fengjh97/robotiq-2f140-td005g-jaw/v7_PLA_only/README.md

# v7：纯 PLA 版（不用 TPU）

> **拷 U 盘直接打 → 用 [`USB_gcode/`](USB_gcode) 里的 `.gcode.3mf`**（已经切好片；PLA 装在哪个喷头，就选文件名带 `_LEFT` 还是 `_RIGHT` 的）。这一层的 `.3mf` 是工程文件，要先在 Bambu Studio 里切片才能打。

**只有 PLA 时用这个文件夹**：只用左喷头，全程不换料。

## 文件
| 顺序 | 文件 | 内容 | 时间* | 用料 |
|---|---|---|---|---|
| ① 试作件 | `trial_v7_PLA_rings_SML.3mf` | 7 mm 厚的环切片，S/M/L 各 2 个（刻痕 1/2/3 道 = S/M/L），从左到右排列 | **约 1 小时 6 分** | 30 g |
| ② 正式件 | `final_v7_S_PLA_only_H2DPro.3mf` / `final_v7_M_…` / `final_v7_L_…` | 两个夹爪，根部 100% 填充修改器已设好 | **约 7 小时** | 约 245 g |

\*用 OrcaSlicer 2.4.2 和 Bambu H2D Pro 0.4 喷嘴官方配置实际切片得到。3MF 里还留着 TPU 这个耗材槽，但没有用到，可以不管。

## 怎么箍住（不靠软材料）
PLA 不适合做弹簧，长期受力会蠕变、慢慢松掉，所以这一版完全靠几何结构：
1. **贴合的硬环**：环腔只比握把大 **0.3 mm**。用 S/M/L 试作件挑出最贴合的尺寸，S/M/L 之间半径差 0.6 mm。
2. **横向细齿 + 锥度楔紧**：环内侧有一圈圈 0.5 mm 高的横向细齿，咬住握把表面的橡胶。握把上粗下细，起子一往下滑就会楔紧在环里。
3. **机头托底**：万一起子往下滑，最多滑几毫米，机头就会落到夹爪的“肩膀”上，掉不下去。
4. **自锁**：2F-140 是自锁的，起子往外撑也推不开手指。

## 选尺寸标准（在扳机下方、离机头底面约 4–5 cm 的地方试）
| 手感 | 判断 |
|---|---|
| ✅ 两个半环用手轻轻一压就完全合上，榫头能插进去；合上后起子基本不晃，往下拉时能感觉到细齿咬住 | **就是这个尺寸** |
| 合不上，还留着缝 | 太紧，换小一号 |
| 合上以后起子明显能晃、能转 | 太松，换大一号 |

挑出来以后，直接打同字母的 `final_v7_*`。

## 跟 v6（PLA + TPU）比
- **少了 TPU 内衬**：容错从约 ±0.8 mm 降到约 ±0.3 mm，所以**一定要先打试作件选尺寸**。
- **不变的部分**：本体结构、M5×16 螺丝加外径 12 mm 垫圈、拧紧力矩 0.8 N·m、夹持力 25–35 N、强度分析结论，都跟 v6 一样。
- **对位精度**：环跟握把只差 0.3 mm，机器人前后方向尽量对准在 ±2 mm 以内。偏了的话，环的弧面会把起子推正，起子是立在桌上的，推得动。
- **碰撞检查**（模型）：
  - 抓住时两个夹爪离握把都是 0.29 mm
  - 合拢全过程，在高度误差 ±3 mm 范围内都不碰，最小间隙 0.17 mm
  - 全开往下伸经过机头时，间隙 2.66 mm

## 打印设置（3MF 里已经设好，在 Bambu Studio 里打开就行）
| 项目 | 设置 |
|---|---|
| 打印机 | Bambu Lab H2D Pro，0.4 喷嘴 |
| 基础工艺 | 0.20mm Standard @BBL H2DP（Bambu 官方预设） |
| 耗材 | Bambu PLA Basic，**左喷头**（文件里还有一个 TPU 槽位，没用到，不用管） |
| 热床板 | **纹理 PEI 板**，55 °C |
| 喷嘴温度 | 220 °C |
| 层高 | 0.2 mm（首层也是 0.2 mm） |
| 支撑 | 不加（背面朝下摆放，悬空部分都在 45° 以内） |
| 擦料塔 | 关 |
| 速度、风扇、边缘（brim） | 用官方默认值（外墙 200 / 内墙 300 / 填充 350 mm/s，风扇最大 80%，边缘自动） |

| | 试作件 `trial_v7` | 正式件 `final_v7_S/M/L` |
|---|---|---|
| 墙数 | 3 圈 | **5 圈** |
| 顶层 / 底层 | 各 4 层 | **各 6 层** |
| 填充 | 15% 螺旋体 | **20% 螺旋体** |
| 根部加强 | 没有 | 靠螺丝孔那一端 25 mm 用 **100% 填充**（透明修改器 `root_100pct`，本身不打印） |
| 时间 / 用料 | 约 1 小时 6 分 / 30 g | 约 7 小时 / 245 g |

墙数、顶底层和根部填充是按强度分析定的：应力集中在表面和根部，所以加墙、加根部填充比整体加填充更有效。
