fengjh97/robotiq-2f140-td005g-jaw/v7_PLA_only/USB_gcode/README.md

# 拷 U 盘直接打印的切片文件（.gcode.3mf）

这些文件**已经切好片**，拷到 U 盘、插到 H2D Pro 上，在屏幕里选中就能打印。

## 先确认 PLA 装在哪个喷头上
打印机屏幕 → **耗材**：看 PLA 是挂在左喷头还是右喷头（AMS 接在哪一边，或者用的哪边外挂料架）。

| PLA 装在 | 用文件名带这个后缀的 |
|---|---|
| **左**喷头 | `…_LEFT.gcode.3mf` |
| **右**喷头 | `…_RIGHT.gcode.3mf` |

## 打哪个
| 顺序 | 文件 | 时间 | 用料 |
|---|---|---|---|
| ① 试作件 | `trial_v7_PLA_rings_SML_LEFT/RIGHT` | 约 1 小时 6 分 | 30 g |
| ② 正式件（选试作件里合适的尺寸） | `final_v7_S_…` / `final_v7_M_…` / `final_v7_L_…` | 约 7 小时 | 约 245 g |
| ②' **XXL 正式件**（L 也紧的话打这个） | `final_v7_XXL_PLA_only_H2DPro_LEFT/RIGHT` | 约 6 小时 53 分 | 约 242 g |

## U 盘打印步骤
1. U 盘格式要是 FAT32 或 exFAT，把 `.gcode.3mf` 文件拷进去（放在根目录最好找）。
2. U 盘插到打印机的 USB 口上 → 屏幕上进**文件**（存储）→ 选 U 盘 → 选文件。
3. 开始前确认：耗材 1（PLA）对应到实际装 PLA 的那个槽或料架；热床板放的是**纹理 PEI 板**。然后开始打印。

## 说明
- 用 **OrcaSlicer 2.4.2** 加 **Bambu Lab H2D Pro 0.4 喷嘴官方配置**（工艺 0.20mm Standard、耗材 Bambu PLA Basic）切的；机型 ID 已经设成 H2D Pro（O1E），G-code 校验值没问题，带预览图。
- 如果打印机提示“文件不是用 Bambu Studio 生成的”之类的话，选继续就行。万一打印机拒绝打印，就在电脑上用 Bambu Studio 打开上一层文件夹里对应的 `.3mf`（不带 gcode 的那个）→ 切片 → “导出切片文件”，再拷到 U 盘。
- 设置：试作件 3 圈墙、15% 填充；正式件 5 圈墙、顶底各 6 层、20% 螺旋体填充，根部 25 mm 是 100% 填充；层高 0.2 mm，喷嘴 220 °C，热床 55 °C，不加支撑。

## XXL（2026-10-26 新增）
实际试装发现 L 还是有点紧，所以加了 XXL：环腔半径比 L 大 1.2 mm（比 M 大 1.8 mm），其他结构跟 S/M/L 完全一样。

## M+5mm（2026-10-26 新增）
环的**内径比 M 大 5 mm**（半径大 2.5 mm，比 XXL 还大 0.7 mm）。为了让环两端的壁保持够厚，夹爪宽度从 62 mm 加到 **68 mm**，其他结构不变。
文件：`final_v7_Mplus5mm_PLA_only_H2DPro_LEFT/RIGHT.gcode.3mf`，约 **7 小时 35 分**，PLA 约 263 g，一盘出两个夹爪。
