fengjh97/robotiq-2f140-td005g-jaw/docs/pla_design_notes_v5_zh.md

# v5 PLA 版：Robotiq 2F-140 × Makita TD005G 环抱式夹爪

抓取姿态跟 v4 一样：夹爪倾斜 9°，越过扳机，环抱在机头底面往下 33–64 mm 的握把上。这一版只针对 **PLA 的弱点**做了加强。

## PLA 的问题和对策
Bambu PLA Basic 官方数据：拉伸强度 39 MPa（沿层）/ 35 MPa（跨层），弯曲强度 76 / 68 MPa，热变形温度 54 °C。短期强度跟 PETG-CF 差不多，但有三个弱点。

| PLA 的弱点 | 会出什么问题 | v5 的对策 |
|---|---|---|
| **蠕变**（长期受力会慢慢变形） | 螺丝头下面的塑料被慢慢压扁，螺丝松动，指尖晃 | 螺丝换 **M5×16**，底板加厚到 **8 mm**（螺纹拧进夹爪的深度还是 8 mm，跟原厂一样）；螺丝头下加**外径 12 mm 的大垫圈**，承压面积是不加垫圈的 2.8 倍；夹持力降到 **25–35 N**，螺丝拉力降到原来的四分之一左右 |
| **脆**（受冲击容易裂） | 撞了容易断 | 应力水平压得很低；同时它也起到保险丝的作用，撞了是 PLA 指尖断，不是夹爪本体坏。**建议多打一对备用** |
| **怕热**（54 °C 开始软化） | 放在车里或者阳光下会变形 | 室内使用没问题；夏天别放在车里 |
| 没有 TPU 做内衬 | — | 环内侧贴 **2 mm 厚 EPDM 海绵胶带**（五金店的“隙間テープ”），或者 **1 mm 厚橡胶片**。两种都行，环腔已经按这两种厚度留好了 1.2 mm 的空间 |

## 有限元结果（PLA，E = 2.68 GPa）
P1 单元会低估约 20%，下表已经乘了 1.2 修正。“最大”是 99.9 分位值，括号里是局部峰值。

| 工况 | 最大 von Mises 应力 | 跨层拉应力 | 环处变形 |
|---|---|---|---|
| 夹持 30 N | 2.3（3.4）MPa | 1.8 MPa | 0.12 mm |
| 夹持 30 N + 起子悬挂按 3g 算 | 2.9（4.4）MPa | 2.2 MPa | 0.16 mm |
| 夹持 30 N + 侧向 30 N（最危险的工况） | 4.2（5.5）MPa | 2.6 MPa | 0.21 mm |
| 对比：开满力 125 N | 9.5（14）MPa | 7.3 MPa | 0.50 mm |

- **短期安全系数**：跨层 35 / 2.6 ≈ **13 倍**。
- **长期蠕变**：PLA 在室温下长期受力，大约强度的 20%（约 7 MPa）以内不会明显蠕变。30 N 各工况都在这个范围内，安全系数约 **2.5 倍**。
- 如果开满力 125 N，跨层应力会超过 7 MPa，PLA 会慢慢变形，**所以一定不要开满力**。

## 螺丝接口
螺丝拉力约等于夹持力 × 80 / 5.35。

| 夹持力 | 螺丝拉力 | 垫圈下承压（外径 12 mm 垫圈，承压面积 91 mm²） |
|---|---|---|
| 30 N | 450 N | 4.9 MPa ✓ |
| 50 N | 750 N | 8.2 MPa（开始有蠕变风险） |
| 125 N | 1870 N | 21 MPa ✗ |

- **拧紧力矩 0.8 N·m**，预紧力约 800 N，大于工作时的 450 N，接合面不会张开；垫圈下面约 9 MPa，PLA 能接受。
- 螺纹胶用**中强度**（蓝色）。因为预紧力比较小，要靠螺纹胶防松。
- 用 24 小时后复拧一次，以后每个月检查一下。

## 够不够抓得住（30 N）
- **环形封闭**：前后左右都关住了；椭圆截面在椭圆环里也转不动。
- **锥度楔紧**：握把上粗下细，起子往下滑会楔死在环里。往外撑的力由 2F-140 的自锁机构承受。
- **摩擦**：EPDM 和握把之间 μ 约 0.8，摩擦力 2 × 0.8 × 30 = 48 N，超过按 3g 算的设计载荷 44 N。
- **结论**：30 N 就够用。不要为了“更稳”去开大力，那只会让 PLA 蠕变。

## 打印参数（Bambu PLA Basic，H2D Pro）
- **摆放**：背面贴床（STL 已经摆好），不用支撑。这样根部弯曲的主应力走在层内。
- **层高**：0.2 mm。墙 **6 圈**，顶底各 **6 层**。
- **填充**：30% 螺旋体（gyroid）。加一个修改器，把**安装面往上 25 mm 的根部**填充改成 **100%**：打印方向上就是零件**靠近螺丝孔那一端、长约 25 mm 的一段**。
- **喷嘴温度**：220 °C（比默认高 5–10 °C，层间结合更好）。外墙速度放慢一点。
- **单件**约 140–160 g，2 件放一块板。
- **试装**：先打 `FITTEST_ring_v5_PLA_x2.stl` 两个（大约 1 小时），**贴好胶带**套到真起子上试，确认能合拢、不太紧也不晃。

## 需要准备的零件
- M5×16 内六角螺丝 2 颗（原厂的 M5×12 在这一版**太短**，不能用）
- M5 平垫圈，外径 12 mm（外径 10 mm 也能装，但承压面积会小一些）2 片
- 2 mm EPDM 海绵胶带，或者 1 mm 橡胶片（贴在环腔内侧，避开两半环的对接面）
- 能伸进去 110 mm 以上的 4 mm 内六角（长柄球头内六角，或者 4 mm 六角批头加加长杆）
- 中强度螺纹胶

## 装配
1. 环腔内侧贴胶带：只贴中间那一段（就是比上下稍微凹进去一点的区域），对接面和榫头上不要贴。
2. 拧下原厂指尖，**定位销留在夹爪上**。把 PLA 指尖对准定位销放上去。
3. 从指尖最下端的孔，依次把垫圈和 M5×16 螺丝放进去（可以用一点双面胶或磁铁把垫圈临时粘在螺丝头上）。用长内六角拧到 **0.8 N·m**。
4. 两个指尖是同一个零件，另一个转 180° 装在另一根手指上。
5. 夹持力设 **25–35 N**，先空夹确认两半环能合上，再去抓起子。
