fengjh97/robotiq-2f140-td005g-jaw/docs/v6_design_notes_zh.md

# v6：PLA 本体 + TPU 方向性软鳍内衬

抓取姿态跟 v4/v5 一样：夹爪倾斜 9°，越过扳机，环抱在机头底面往下 33–64 mm 的握把上。本体结构跟 v5 一样（M5×16 螺丝、8 mm 底板、外径 12 mm 大垫圈），区别在环内侧：**泡棉胶带换成了 TPU 软鳍内衬**。

## 为什么 PLA + TPU 更好
| 方案 | 两半环能不能合上（30 N 夹持力） | 握把尺寸误差容忍度 | 防止往下滑 |
|---|---|---|---|
| v4.1 实心 TPU 肋 | 合不上，95A 太硬压不动，会留约 0.6 mm 的缝 | 约 ±0.3 mm | 一般 |
| v5 泡棉胶带 | 基本能合上 | 约 ±0.5 mm | 一般，泡棉会老化 |
| **v6 TPU 软鳍** | **能完全合上**（鳍片完全压平只需约 16 N/侧） | **约 ±0.8 mm** | **方向性：往下滑的阻力远大于合拢时的阻力** |

**软鳍的原理**
- 鳍片厚 0.8 mm、长 3.5 mm，**斜 45° 朝向机头**，一共 7 圈，自由状态下鳍尖伸进握把 0.8 mm。
- 2F-140 合拢时指尖走圆弧，环会**顺着握把往下滑约 19 mm**。这个方向相当于顺着鳍片的倒向，鳍片被顺势压平，几乎不阻碍合拢。
- 起子要往下掉时方向相反，鳍尖被往下拖、立起来顶住，像倒刺一样**越拉越紧**。
- PLA 负责结构强度，TPU 负责贴合和抓握，各干各擅长的事。

## 强度（有限元，PLA，夹持力 30 N）
跟 v5 基本一样。最坏工况（夹持 30 N + 侧向 30 N）：
- von Mises 约 3.3 MPa（99.9 分位），局部峰值约 4.8 MPa
- 跨层拉应力 2.3 MPa
- 环处变形 0.17 mm

内衬凹槽加深对强度没有影响，因为应力都集中在根部，环那一段基本不受力。短期安全系数约 15 倍，长期蠕变约 3 倍。螺丝拉力 450 N，垫圈下承压 4.9 MPa。

## 碰撞检查（运动学模型）
| 项目 | 结果 |
|---|---|
| 全开下探过机头 | 最小间隙 2.7 mm |
| 合拢全过程（夹爪高度误差 ±3 mm） | 不碰起子，最小间隙 0.9 mm |
| 抓住时 PLA 硬壳到握把 | 1.2–1.4 mm（这里是软鳍的位置） |
| 指尖到夹爪自身连杆 | 最小 1.0 mm |

## 打印时间和用料（OrcaSlicer 2.4.2 实际切片，Bambu Lab H2D Pro 0.4 喷嘴官方配置）
| 任务 | 内容 | 设置 | 时间 | 用料 |
|---|---|---|---|---|
| ① 试装（推荐先打） | `FITTEST_ring_slice_v6_x2`：12 mm 厚的环切片 ×2 | PLA，4 圈墙，15% 填充 | **37 分钟** | 19 g |
| ① 试装（可以同一块板） | `FITTEST_liner_slice_v6_TPU_x2`：12 mm 厚的内衬切片 ×2 | TPU 95A HF | 19 分钟 | 3 g |
| ② 本体 | `PRINT_jaw_v6_PLA_body_x2` ×2 | PLA Basic，5 圈墙，20% 螺旋体填充，根部 25 mm 设成 100% | **约 6.5–6.7 小时** | 约 245 g |
| ②'（不加根部修改器） | 同上 | 全部 20% | 6 小时 11 分钟 | 200 g |
| ③ 内衬 | `PRINT_liner_v6_TPU_fins_x2` ×2 | TPU 95A HF，3 圈墙，100% 填充 | **29 分钟** | 6.8 g |
| （参考）旧的完整试装件 | `FITTEST_ring_v6_PLA_x2` ×2 | PLA，4 圈墙，15% 填充 | 3 小时 2 分钟 | 96 g |

**合计**：试装约 1 小时，正式件约 7 小时（PLA 和 TPU 分两个任务打），PLA 约 265 g，TPU 约 10 g。
根部修改器的位置：零件在打印方向上靠近螺丝孔那一端，Y 方向 25 mm 的一段（零件背面贴床时，螺丝孔所在的那一头）。

## 打印参数
- **PLA 本体**（Bambu PLA Basic）：
  - 背面贴床（STL 已经摆好），不用支撑；层高 0.2 mm；喷嘴 220 °C。
  - 5 圈墙，顶底各 6 层，20% 螺旋体（gyroid）填充。
  - **根部修改器**：零件靠螺丝孔那一端、长约 25 mm 的一段，填充改成 100%。
- **TPU 内衬**（TPU 95A HF）：
  - 端面朝下竖着打（STL 已经摆好），100% 填充，速度 20–30 mm/s，回抽调小。
  - 鳍片悬垂约 45–54°，TPU 能打出来；鳍片下面稍微有点毛边也不影响使用。

## 装配
1. TPU 内衬是 C 形的，捏一下就能卡进环腔中间那段比上下凹进去一点的槽里。
2. 装的时候**鳍尖要朝指尖安装面那一端**（也就是装到夹爪上以后鳍尖朝上、朝机头）。装反了防滑效果就反过来了。
3. 想更牢可以在内衬背面点几滴 CA 胶，PLA 和 TPU 粘得住。
4. 拧下原厂指尖，定位销留在夹爪上。M5×16 螺丝套上外径 12 mm 的平垫圈，从指尖最下端的孔放进去，用长 4 mm 内六角拧到 **0.8 N·m**，点中强度螺纹胶。24 小时后复拧一次。
5. 两个指尖是同一个零件，另一个转 180° 装。夹持力设 **25–35 N**。

## 零件清单
- M5×16 内六角螺丝 ×2
- M5 平垫圈，外径 12 mm ×2
- 能伸进去 110 mm 以上的 4 mm 内六角（长柄球头，或者 4 mm 六角批头加加长杆）
- 中强度螺纹胶
- 不用再买 EPDM 胶带了
