fengjh97/robotiq-2f140-td005g-jaw/docs/onepiece_notes_zh.md

# 一体成型打印说明：final_S/M/L_onepiece_H2DPro.3mf（选择跟试作件同尺寸的文件）

**用 Bambu Studio 直接打开这个文件，点切片，然后打印。**

## 文件里已经设置好的内容
- 2 个夹爪。每个夹爪包含 3 个部件：
  - **PLA 本体**（耗材 1）
  - **TPU 软鳍内衬**（耗材 2），已经放在凹槽里，打印时直接熔合在本体上，不用粘也不用装
  - **根部 100% 填充修改器**（螺丝孔那一端，长 25 mm）
- **打印机**：Bambu Lab H2D Pro，0.4 喷嘴；工艺 0.20mm Standard，改为 5 圈墙、顶底各 6 层、20% 螺旋体填充、不加支撑。
- **喷嘴分配**：手动模式，**PLA 用左喷头，TPU 用右喷头**（Bambu 官方规定 H2D 的 TPU 只能用右喷头，从背面 TPU 口进料）；擦料塔已经放在两个喷头都能到的位置。
- **方向**：零件已经摆好打印方向，背面贴床。

## OrcaSlicer 2.4.2 实际切片结果（H2D Pro 官方配置）
- **总时间约 8 小时 44 分**
- PLA 约 254 g，TPU 约 12 g（都包含换料冲刷和擦料塔）
- 分开打的话合计约 7.2 小时：PLA 本体 6.7 小时 + TPU 内衬 0.5 小时。一体成型多出来的约 1.5 小时花在换喷头上，换来的是不用组装、内衬和本体熔合在一起。

## 打开后检查这三项
1. 耗材 1 = Bambu PLA Basic，耗材 2 = Bambu TPU 95A HF。把 AMS 或外挂料架里实际装的料对应上，TPU 从**机器背面的 TPU 专用进料口**进**右喷头**（不能走 AMS）。
2. 喷嘴分配显示 TPU 在**右**、PLA 在**左**。如果不是，在喷嘴分配里选手动，改过来。
3. 每个夹爪下面应该能看到 `root_100pct` 这个修改器，它是透明的，不会打印出来。如果打开时 Bambu Studio 提示“只加载几何数据”，这个修改器会变成实心块被打印出来。遇到这种情况，把它的类型改成“修改器”（右键 → 更改类型），或者直接删掉它（删掉的话根部按 20% 填充打，强度会低一点）。

## 注意
- 内衬和本体熔合成一体以后**拆不下来**，内衬磨损了就要整个重打。
- 螺丝用 **M5×16** 加外径 12 mm 的垫圈，拧到 0.8 N·m，从夹爪最下端的通道拧进去。
- 两个夹爪是同一个零件，另一个转 180° 装在另一根手指上。夹持力设 25–35 N。
- TPU 打印前烘一下：65 °C，6–8 小时。
