fengjh97/robotiq-2f140-td005g-jaw/docs/strength_analysis_v41_zh.md

# v4.1 力学分析：到底箍不箍得住

## 0. 结论先说
- **起子掉不下来，靠的是几何结构，不是摩擦**：
  - 环合上以后，前后左右都被关住；握把截面是椭圆，在椭圆环里也转不动。
  - 握把是上粗下细的锥形，起子往下滑一点就会楔死在环里。
  - 2F-140 本身是自锁的，起子把夹爪往外顶也顶不开。
- **夹爪本体强度**：v4 的薄弱点在螺丝槽根部。v4.1 把背面封闭成管状，同样 125 N 夹持力下，峰值应力从 24.5 降到约 10 MPa，跨层拉应力从 14.5 降到约 5 MPa。
- **真正限制夹持力的是螺丝接口**：接触点离安装面约 80 mm，力臂太长，螺丝要承受很大的拉力。**夹持力设 40–60 N**，这时螺丝受力跟原厂指尖在 125 N 满力时差不多；这个力也足够把起子夹住。
- **最大的不确定性是尺寸**：握把和机头的尺寸是从照片估的。握把比模型细 1 mm 的话，起子会先往下滑大约 12 mm 才楔死，但还是在环里，不会掉。

## 1. 载荷
| 工况 | 载荷 | 说明 |
|---|---|---|
| LC1 | 夹持反力 125 N（2F-140 最大值）/ 50 N（推荐值） | 作用在环腔上，把指尖往外推，力的作用高度约 80 mm |
| LC2 | 每个夹爪 22 N 竖直力 + 50 N 夹持 | 起子 1.5 kg，按 3g 算（加速度、急停都包括在内），两个夹爪平分 |
| LC3 | 30 N 侧向（沿批头方向）+ 50 N 夹持 | 机器人横向加速或者碰撞 |

## 2. 有限元分析（PETG-CF，E = 2.46 GPa，安装面按粘接固定）
P1 网格 11 万个单元，另用二次单元 P2 做了复核（P1 会低估约 15–20%）。表中应力是 99.9 分位值，安装面边角上因为固定边界产生的奇异点已经排除。

| 版本 / 工况 | von Mises 应力 | 跨层拉应力 σyy（会把层拉开） | 环处变形 |
|---|---|---|---|
| v4（槽开在背面）LC1 125 N | 24.5 MPa（螺丝槽根部尖角） | **14.5 MPa** | 0.78 mm |
| **v4.1** LC1 125 N | 约 10 MPa（P2） | 约 5 MPa | 0.57 mm（P2） |
| **v4.1** LC1 50 N | 约 4 MPa | 约 2 MPa | 0.23 mm |
| v4.1 LC2（悬挂 3g + 50 N） | 约 4.5 MPa | 约 2.2 MPa | 0.24 mm |
| v4.1 LC3（侧向 30 N + 50 N） | 约 5 MPa | 约 2.2 MPa | 0.24 mm |

应力分布图见 `stress_maps.png`：应力集中在安装面以上约 0–20 mm 的根部，环那一段几乎不受力。

**材料强度**（Bambu 官方数据表）：
| 材料 | 拉伸强度（沿层 / 跨层） | 弯曲强度（沿层 / 跨层） | 热变形温度 |
|---|---|---|---|
| PETG-CF | 35 / 29 MPa | 70 / 48 MPa | 68 °C |
| PAHT-CF | 88 MPa | 140 / 70 MPa（干态） | 194 °C；层间冲击强度是 PETG-CF 的约 1.2 倍、普通 PA-CF 的 2.3 倍 |

**安全系数（PETG-CF，夹持力 50 N）**：
- 短期静强度：沿层约 9 倍，跨层约 10 倍。
- 长期蠕变 / 反复夹取：按强度的 30% 作为许用应力，约 3 倍。
- 如果按 125 N 满力长期使用，跨层方向的长期安全系数只有约 1.5 倍。所以**别用满力**，量产用的话换 PAHT-CF。

## 3. 螺丝接口（真正的瓶颈）
夹持反力在约 80 mm 高处，把指尖绕安装面背面的边缘往外掀。螺丝离这条边只有 5.35 mm，所以螺丝拉力：

**T ≈ F × 80 / 5.35**

| 夹持力 F | 螺丝拉力 T | 螺丝头下的承压（用 DIN 433 M5 垫圈，外径 9，承压面积 41.5 mm²） |
|---|---|---|
| 125 N | 1870 N | 45 MPa（接近 PETG-CF 的压缩极限，会蠕变松动） |
| 60 N | 900 N | 22 MPa |
| 50 N | 750 N | 18 MPa |
| 对比：原厂指尖 125 N，作用高度约 33 mm | 770 N | — |

- 也就是说，**夹持力 50 N 时，螺丝受力跟原厂指尖满力时差不多**，这是 Robotiq 自己验证过的工况。
- **拧紧力矩**：PETG-CF 用 1.2 N·m（预紧力约 1200 N），PAHT-CF 用 1.5–2 N·m。预紧力必须大于工作时的拉力，接合面才不会张开。
- 用低强度螺纹胶。第一天用完之后复拧一次，因为塑料会蠕变，预紧力会掉一些。
- 两根 Ø2 定位销：剪应力约 20 MPa（钢销没问题），销孔承压约 10 MPa，没问题。

## 4. Robotiq 指尖外载限制（跟夹持力无关）
官方限值：每个指尖 F ≤ 25 N，Mx、My ≤ 5 N·m，Mz ≤ 3 N·m（从指尖底座算起）。
| 项目 | 本方案 | 限值 |
|---|---|---|
| 单指外力（起子按 2g 算，两指平分） | 14.7 N | 25 N |
| 弯矩（起子横着拿，力作用在约 80 mm 高） | 约 1.2 N·m | 5 N·m |
| 扭矩 Mz（重力沿批头方向，力臂 48 mm） | 约 0.7 N·m | 3 N·m |
| 急停按 3g 算的单指外力 | 约 22 N | 25 N（偏紧，急停减速度别设太大） |

## 5. 抓持力怎么来的（为什么说“箍得住”）
1. **环形封闭**：环把握把整圈包住，前后左右都跑不掉；椭圆截面在椭圆环里也转不动。
2. **锥度楔紧**：握把前后深度每 96 mm 收窄 8 mm，锥角约 2.4°。起子往下滑会被楔死在环里，楔紧时的放大倍数约 24 倍。楔紧产生的撑开力由夹爪的自锁机构承受。
3. **摩擦**：摩擦力 = 2 × μ × F。F = 50 N、μ = 0.5 时是 50 N，已经超过 3g 设计载荷 44 N。只算这一项也够了。
4. **两半环合不严的问题**：TPU 95A 内衬太硬，50 N 夹持力几乎压不动它，所以两半环之间会剩约 0.6 mm 的缝（两侧过盈 0.3 mm 加起来）。V 形榫高 2.5 mm，还能插进去约 1.9 mm，环的“笼子”作用照样有效。

## 6. 打印参数（偏重强度）
- **材料**：首选 PAHT-CF（层间结合好、抗蠕变、耐热）。PETG-CF 也行，前提是夹持力 ≤ 60 N，而且不在高温环境下用（比如夏天的车里）。
- **摆放方向**：背面贴床（STL 已经摆好）。这样根部弯曲产生的主应力（沿指尖长度方向）走在层内，跨层方向只剩小量拉应力。
- **墙**：6 圈（约 2.4 mm）。应力集中在表面，墙比填充重要。顶底各 6 层。
- **填充**：整体 30% 螺旋体（gyroid）。在 Bambu Studio 里给**安装面往上 25 mm 的根部**加一个修改器，填充改成 80–100%。
- **PAHT-CF**：打印前 80 °C 烘 8 小时；喷嘴用硬化钢；H2D 的腔体温度尽量开高。打完按数据表 80 °C 退火 12 小时，强度能拿满。
- **PETG-CF**：喷嘴温度取上限，少开冷却风扇，这样层间结合更好。
- 单件大约 110–150 g（看填充设置，以切片软件显示为准）。

## 7. 安装要点
1. 用 DIN 433 M5 垫圈（外径 9 mm，能放进 Ø9.6 的沉孔），螺丝用原厂 M5×12。
2. v4.1 的螺丝通道背面是封闭的，要从**夹爪最下端**把螺丝放进去、拧紧。需要一把伸进去够 105 mm 以上的 4 mm 内六角：长柄球头内六角，或者 4 mm 六角批头加加长杆。
3. 拧紧力矩见第 3 节，点低强度螺纹胶，第一天用完后复拧。
