fengjh97/robotiq-2f140-td005g-jaw/images/fea_pla.png

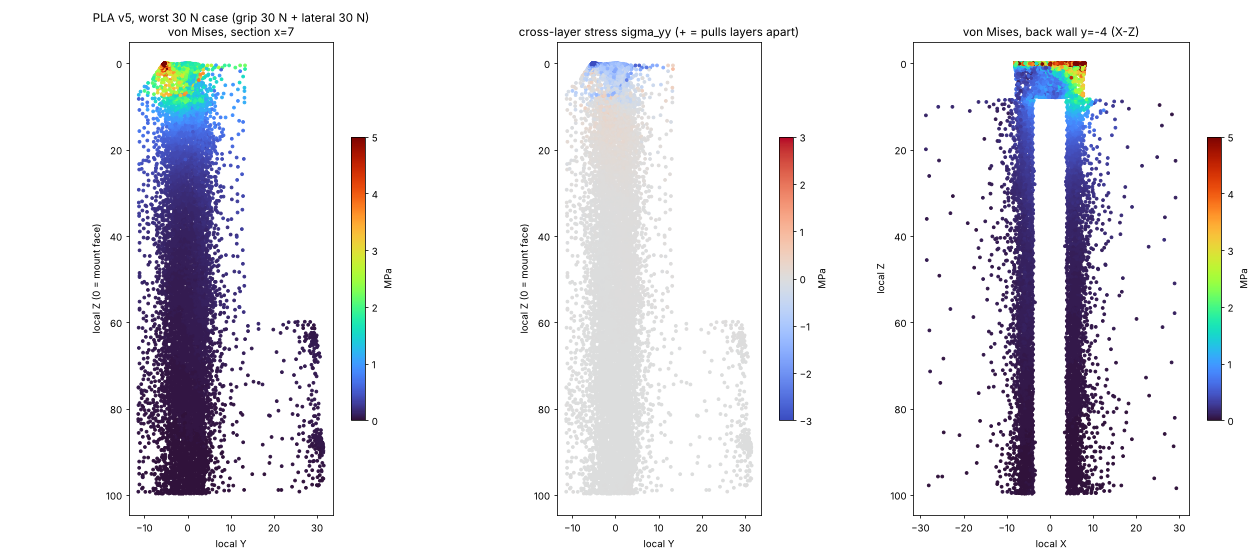
images/fea_pla.png
