fengjh97/robotiq-2f140-td005g-jaw/images/onepiece_plate.png

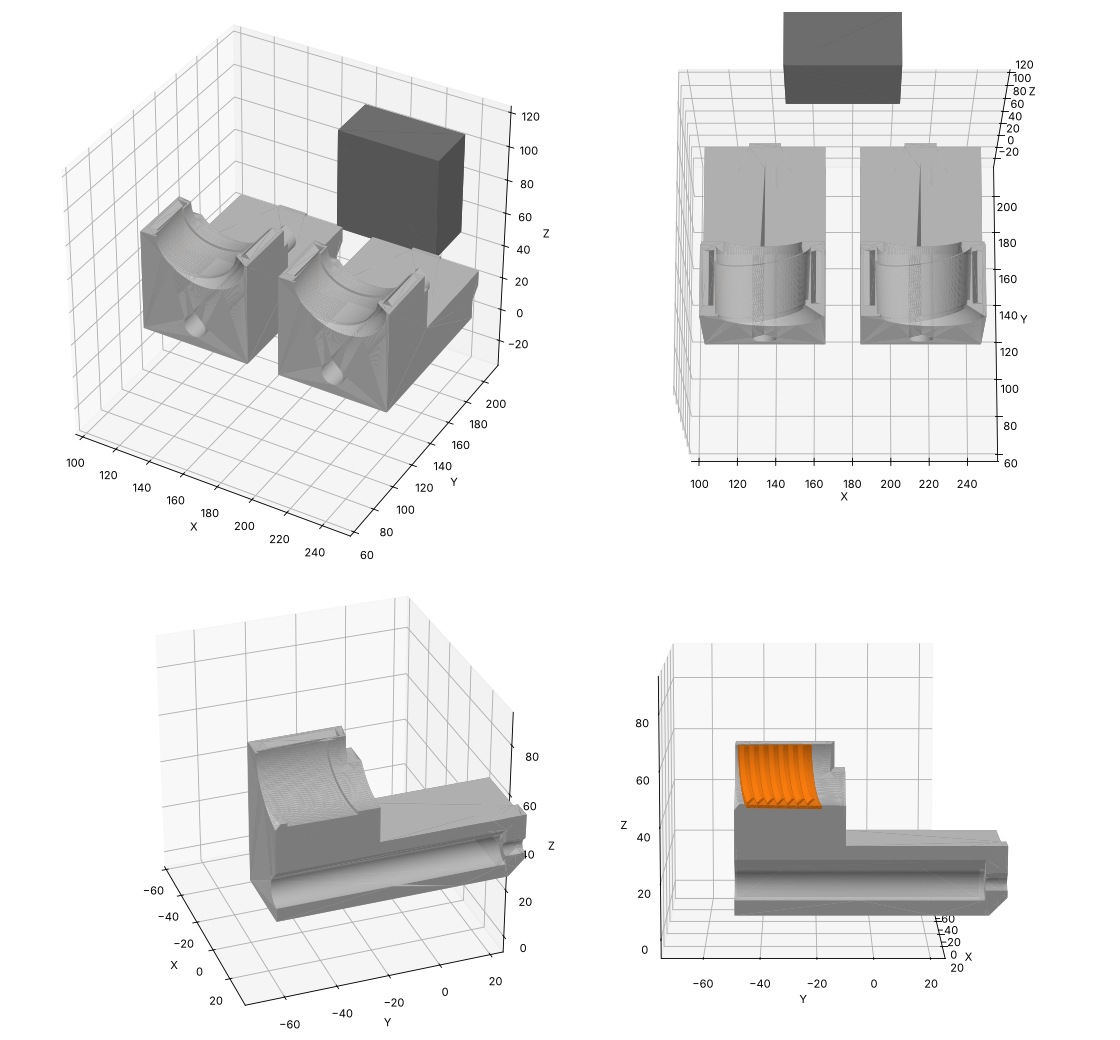
images/onepiece_plate.png
