fengjh97/robotiq-2f140-td005g-jaw/images/v7_trial.png

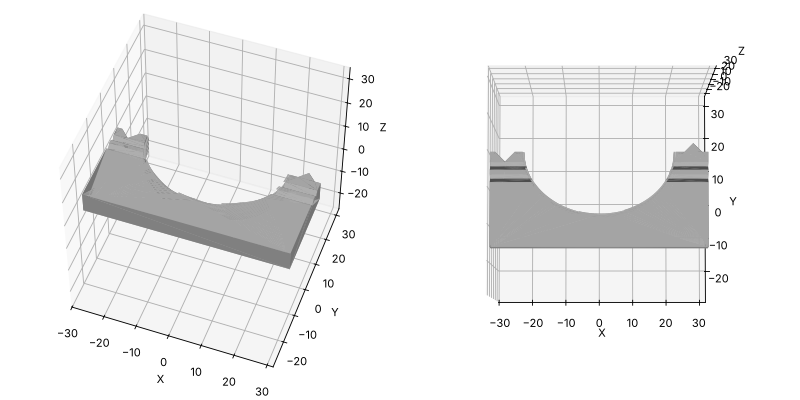
images/v7_trial.png
