fengjh97/robotiq-2f140-td005g-jaw/images/trial_parts.png

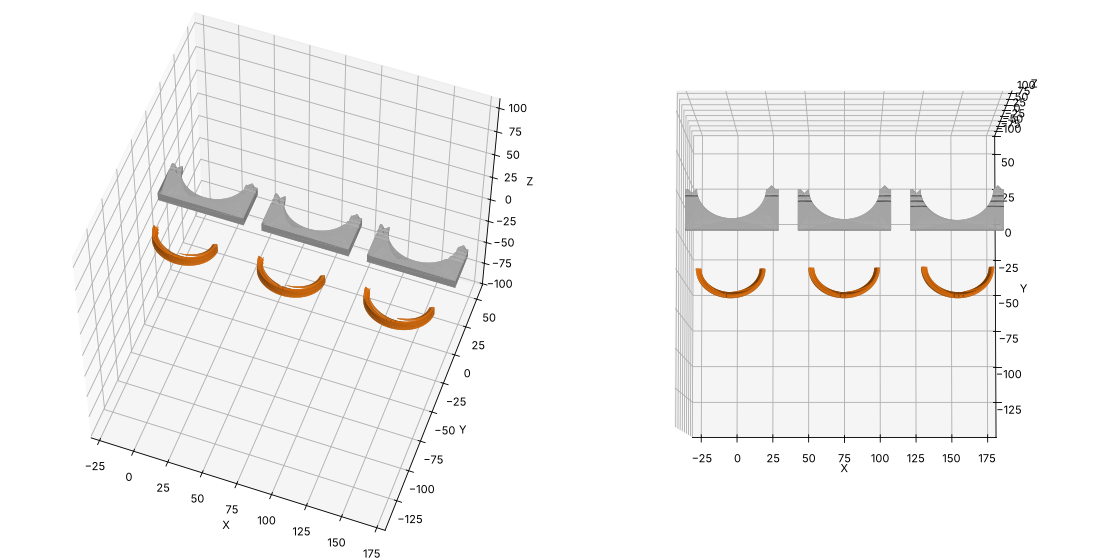
images/trial_parts.png
