fengjh97/robotiq-2f140-td005g-jaw/1_trial/trial1_PLA_rings_SML.3mf

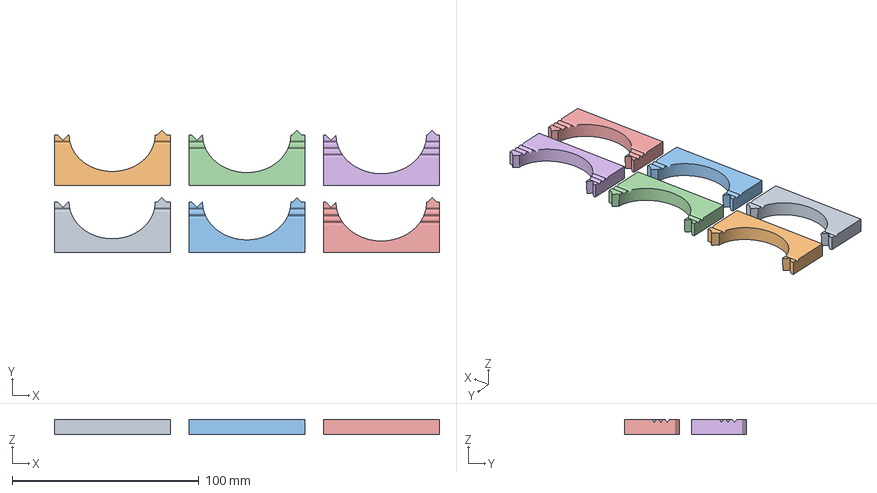
[picture p8: CAD file, 2026-10-23]
1_trial/trial1_PLA_rings_SML.3mf
206.0 x 65.5 x 8.00 mm
ring_S_1
ring_S_2
ring_M_1
ring_M_2
ring_L_1
ring_L_2
