fengjh97/robotiq-2f140-td005g-jaw/2_final/final_L_onepiece_H2DPro.3mf

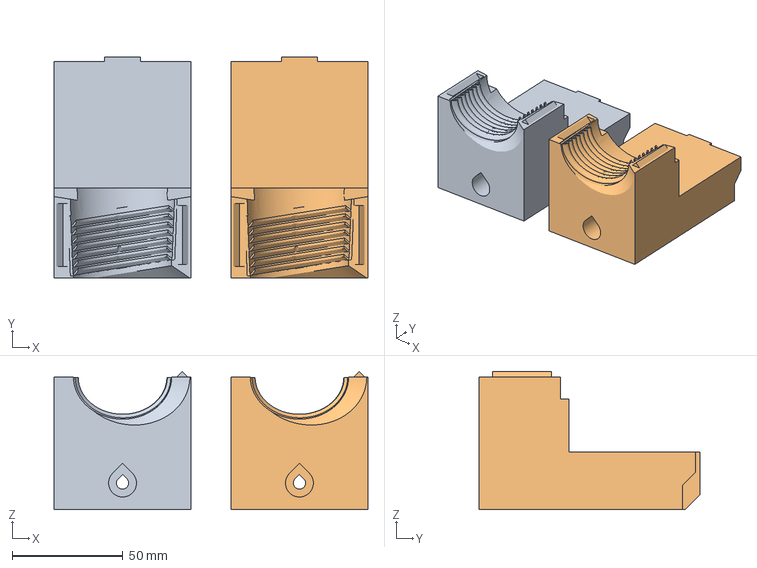
[picture p9: CAD file, 2026-10-23]
2_final/final_L_onepiece_H2DPro.3mf
142.0 x 100.0 x 62.5 mm
jaw_A
jaw_B
