fengjh97/robotiq-2f140-td005g-jaw/3_separate_parts/PRINT_jaw_S_PLA_body_x2.stl

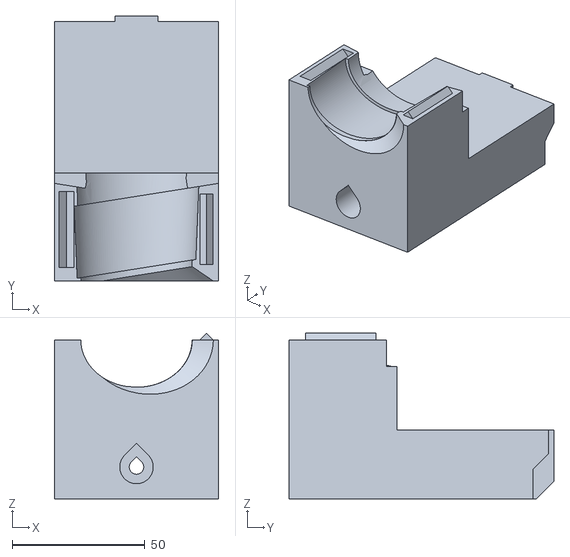
[picture p10: CAD file, 2026-10-23]
3_separate_parts/PRINT_jaw_S_PLA_body_x2.stl
62.0 x 100.0 x 62.5
