fengjh97/robotiq-2f140-td005g-jaw/cad/jaw_v7_Mplus5mm_PLA_only.step

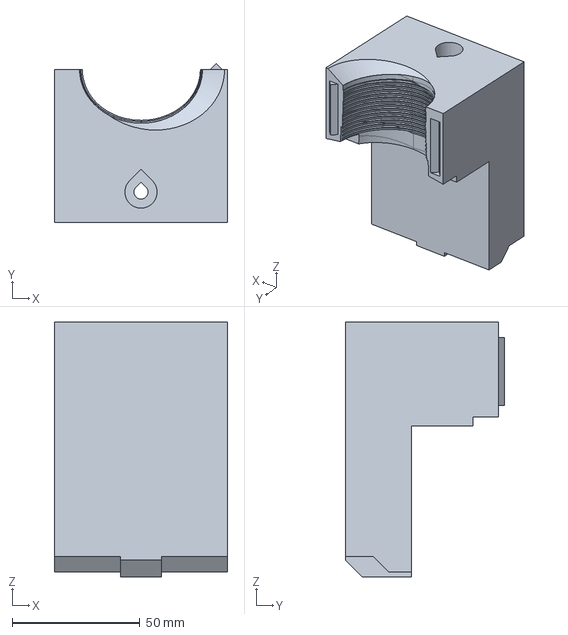
[picture p11: CAD file, 2026-10-26]
cad/jaw_v7_Mplus5mm_PLA_only.step
68.0 x 62.5 x 100.0 mm
