fengjh97/robotiq-2f140-td005g-jaw/v7_PLA_only/USB_gcode/final_v7_Mplus5mm_PLA_only_H2DPro_RIGHT.gcode.3mf

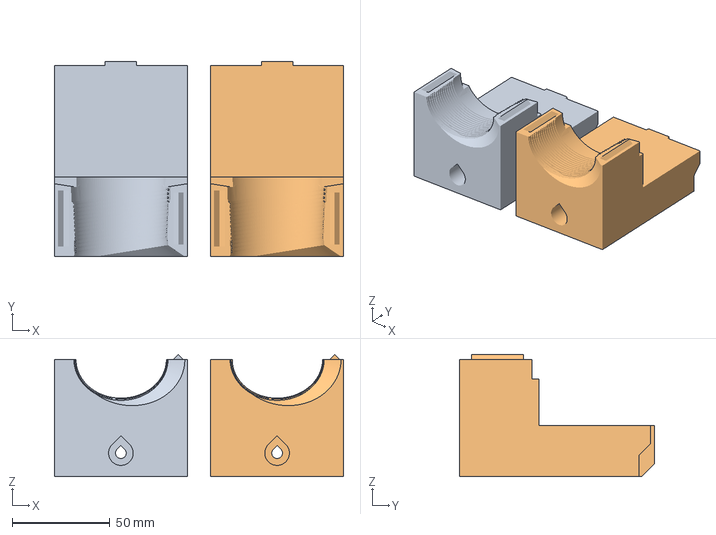
[picture p13: CAD file, 2026-10-26]
v7_PLA_only/USB_gcode/final_v7_Mplus5mm_PLA_only_H2DPro_RIGHT.gcode.3mf
148.0 x 100.0 x 62.5 mm
jaw_A
jaw_B
