fengjh97/robotiq-2f140-td005g-jaw/1_trial/trial_ring_M_PLA.stl

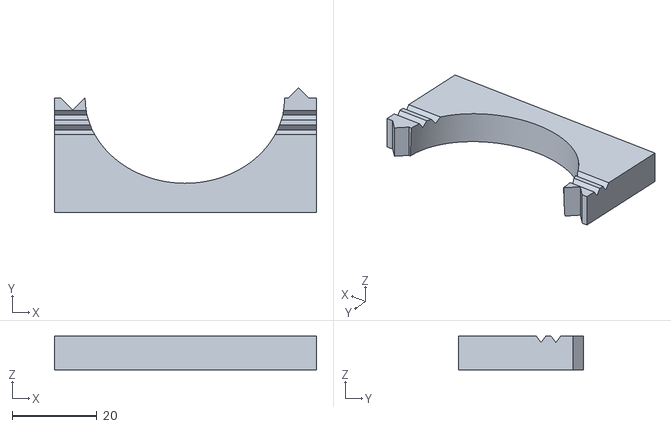
[picture p14: CAD file, 2026-10-23]
1_trial/trial_ring_M_PLA.stl
62.0 x 29.5 x 8.00
