fengjh97/robotiq-2f140-td005g-jaw/3_separate_parts/PRINT_liner_L_TPU_x2.stl

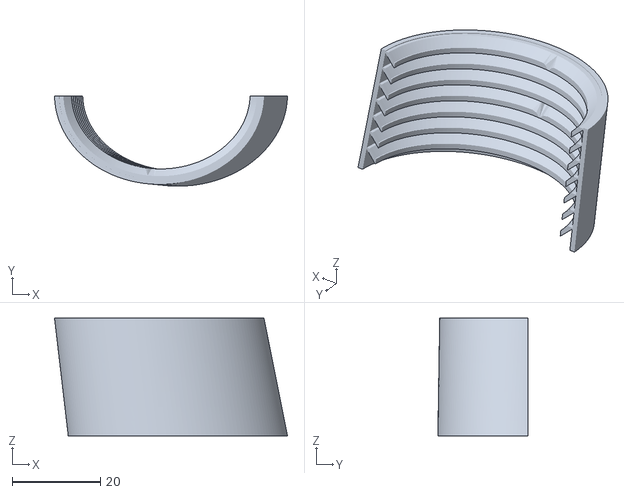
[picture p15: CAD file, 2026-10-23]
3_separate_parts/PRINT_liner_L_TPU_x2.stl
52.8 x 20.5 x 26.7
