fengjh97/robotiq-2f140-td005g-jaw/cad/jaw_v7_XXL_PLA_only.step

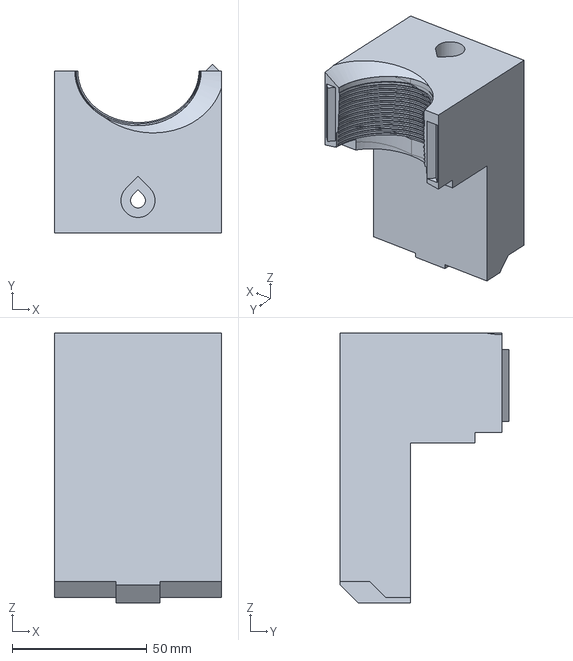
[picture p16: CAD file, 2026-10-26]
cad/jaw_v7_XXL_PLA_only.step
62.0 x 62.5 x 100.0 mm
