fengjh97/robotiq-2f140-td005g-jaw/v7_PLA_only/final_v7_L_PLA_only_H2DPro.3mf

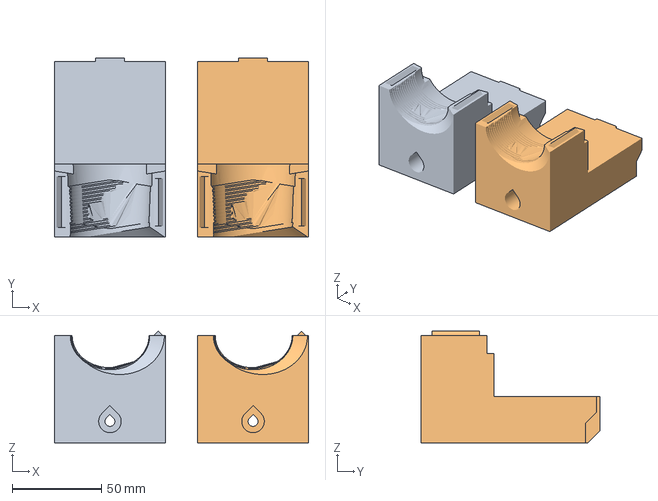
[picture p17: CAD file, 2026-10-26]
v7_PLA_only/final_v7_L_PLA_only_H2DPro.3mf
142.0 x 100.0 x 62.5 mm
jaw_A
jaw_B
