fengjh97/robotiq-2f140-td005g-jaw/1_trial/trial_liner_L_TPU.stl

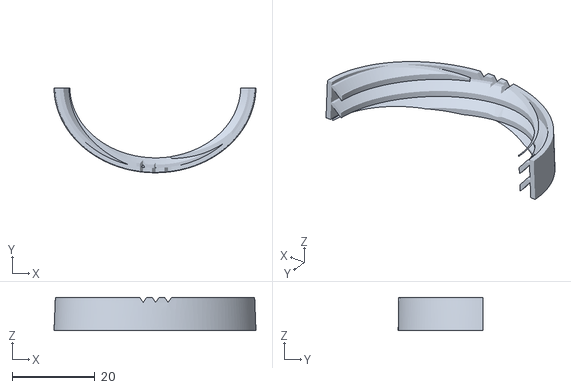
[picture p18: CAD file, 2026-10-23]
1_trial/trial_liner_L_TPU.stl
48.7 x 20.4 x 8.00
