fengjh97/robotiq-2f140-td005g-jaw/v7_PLA_only/stl/trial_v7_M.stl

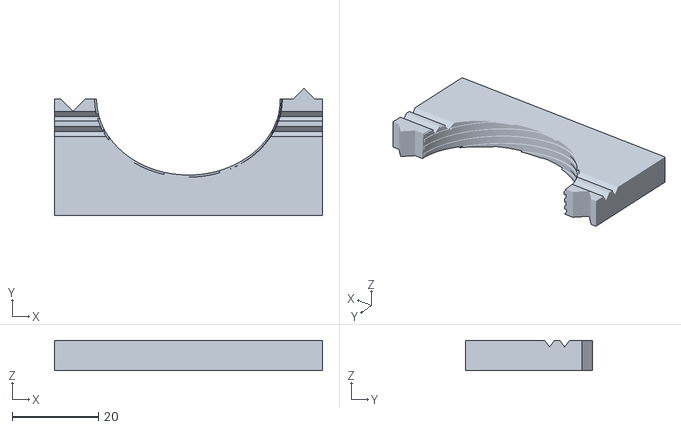
[picture p19: CAD file, 2026-10-26]
v7_PLA_only/stl/trial_v7_M.stl
62.0 x 29.5 x 7.00
