fengjh97/robotiq-2f140-td005g-jaw/v7_PLA_only/trial_v7_PLA_rings_SML.3mf

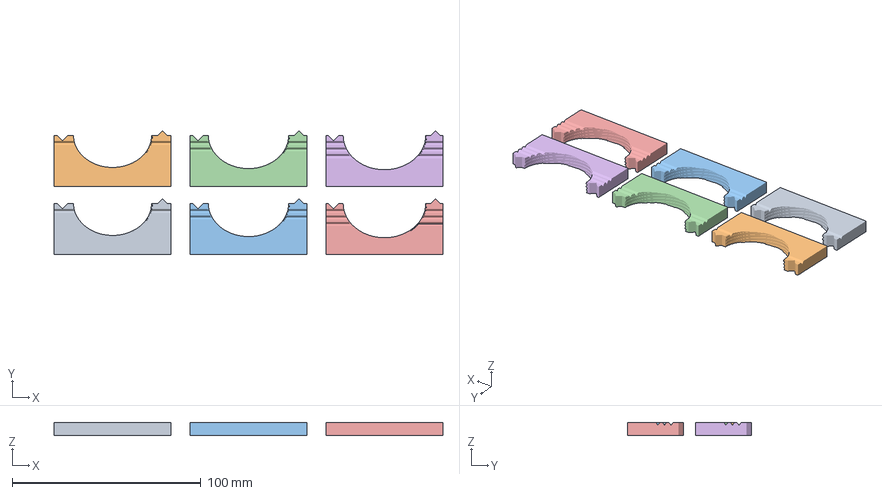
[picture p20: CAD file, 2026-10-26]
v7_PLA_only/trial_v7_PLA_rings_SML.3mf
206.0 x 65.5 x 7.00 mm
ring_S_1
ring_S_2
ring_M_1
ring_M_2
ring_L_1
ring_L_2
