fengjh97/robotiq-2f140-td005g-jaw/1_trial/trial_liner_M_TPU.stl

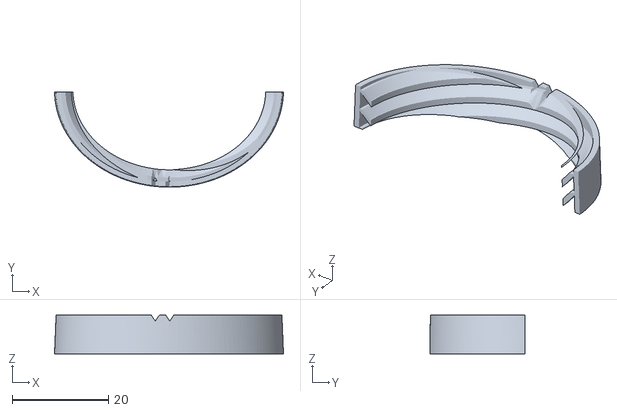
[picture p21: CAD file, 2026-10-23]
1_trial/trial_liner_M_TPU.stl
47.5 x 19.8 x 8.00
