fengjh97/robotiq-2f140-td005g-jaw/cad/TD005G_model.step

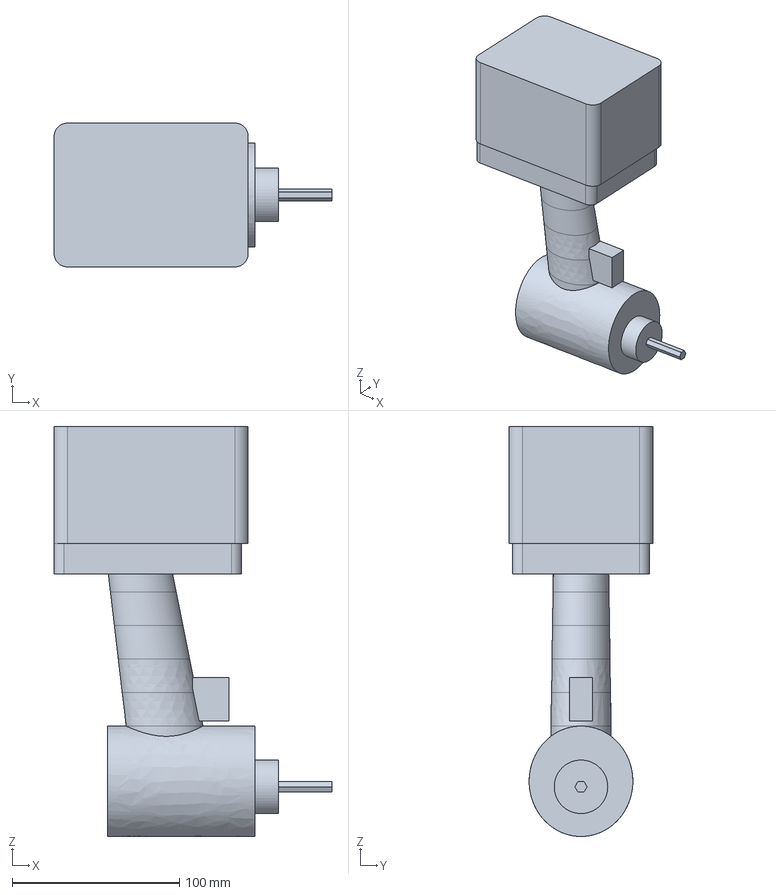
[picture p22: CAD file, 2026-10-23]
cad/TD005G_model.step
166.0 x 86.0 x 245.0 mm
