fengjh97/robotiq-2f140-td005g-jaw/1_trial/trial_liner_S_TPU.stl

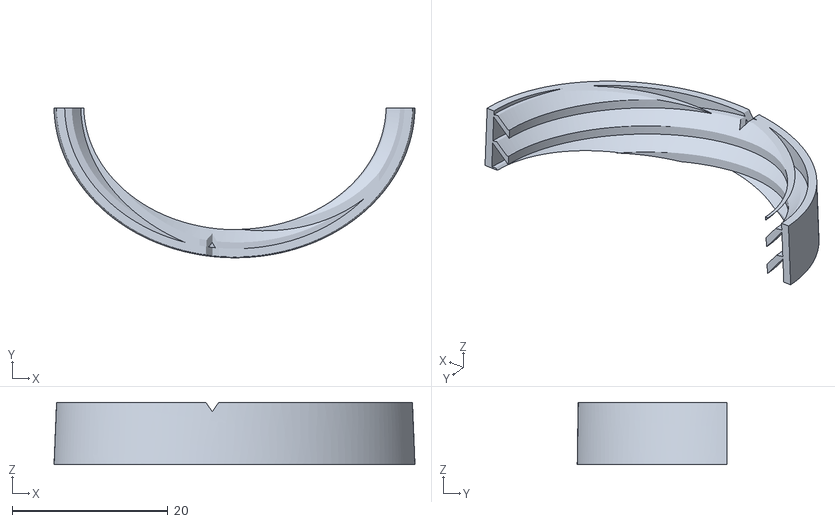
[picture p23: CAD file, 2026-10-23]
1_trial/trial_liner_S_TPU.stl
46.3 x 19.2 x 8.00
