fengjh97/robotiq-2f140-td005g-jaw/3_separate_parts/PRINT_liner_S_TPU_x2.stl

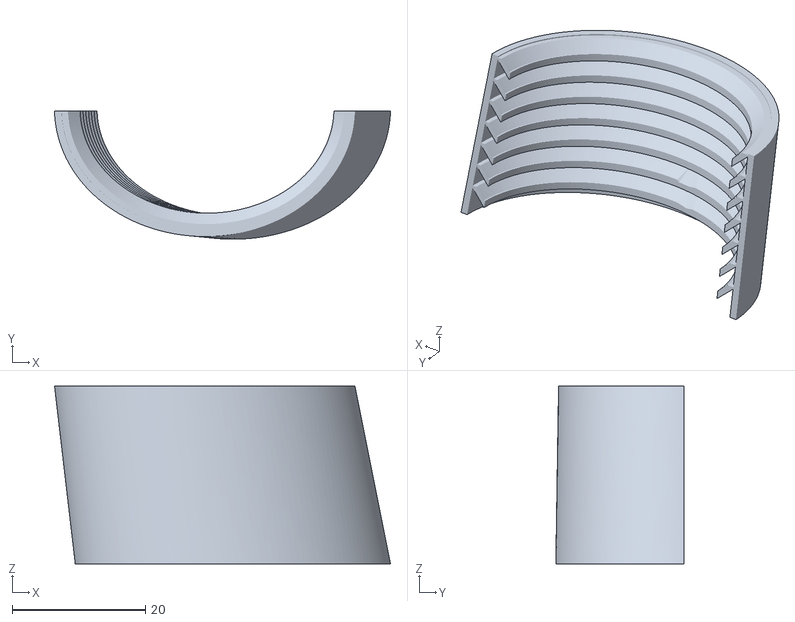
[picture p24: CAD file, 2026-10-23]
3_separate_parts/PRINT_liner_S_TPU_x2.stl
50.4 x 19.3 x 26.7
