fengjh97/robotiq-2f140-td005g-jaw/3_separate_parts/PRINT_liner_M_TPU_x2.stl

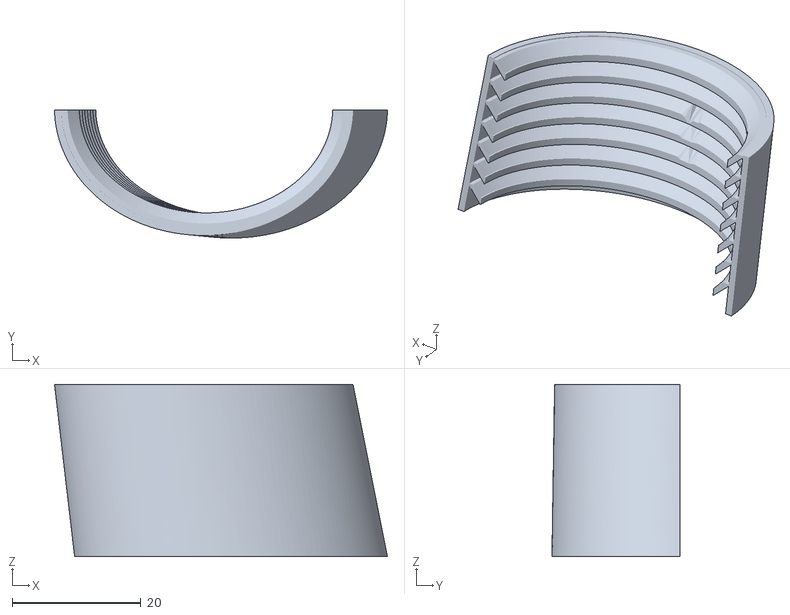
[picture p26: CAD file, 2026-10-23]
3_separate_parts/PRINT_liner_M_TPU_x2.stl
51.6 x 19.9 x 26.7
