fengjh97/robotiq-2f140-td005g-jaw/cad/liner_v6_TPU_fins.step

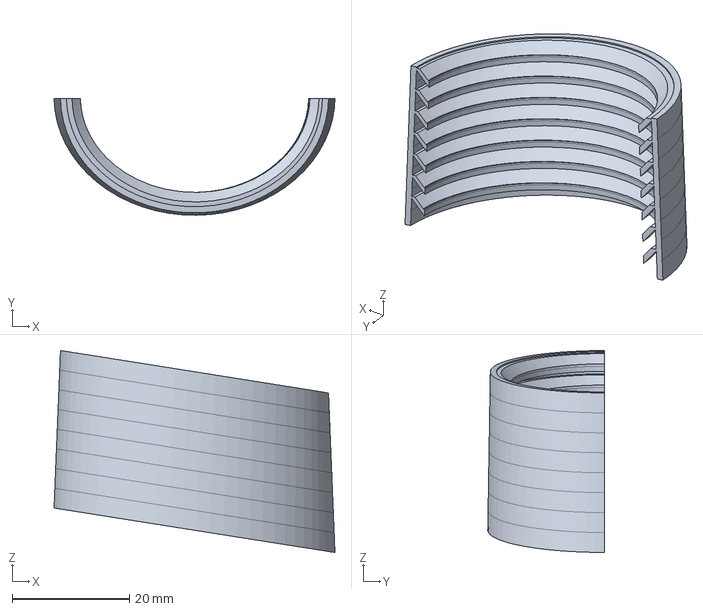
[picture p27: CAD file, 2026-10-23]
cad/liner_v6_TPU_fins.step
47.9 x 19.9 x 34.4 mm
