fengjh97/robotiq-2f140-td005g-jaw/1_trial/trial2_TPU_liners_SML.3mf

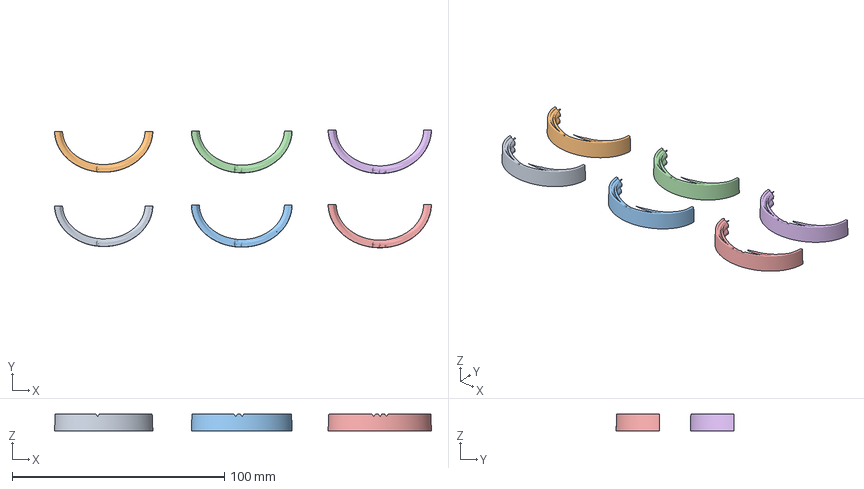
[picture p29: CAD file, 2026-10-23]
1_trial/trial2_TPU_liners_SML.3mf
177.5 x 55.4 x 8.00 mm
liner_S_1
liner_S_2
liner_M_1
liner_M_2
liner_L_1
liner_L_2
