fengjh97/robotiq-2f140-td005g-jaw/(list of files, cad)

Other CAD files:
v7_PLA_only/stl/PRINT_jaw_v7_Mplus5mm_PLA_x2.stl
2_final/final_S_onepiece_H2DPro.3mf
v7_PLA_only/stl/PRINT_jaw_v7_XXL_PLA_x2.stl
v7_PLA_only/USB_gcode/final_v7_Mplus5mm_PLA_only_H2DPro_LEFT.gcode.3mf
2_final/final_M_onepiece_H2DPro.3mf
3_separate_parts/PRINT_jaw_M_PLA_body_x2.stl
cad/jaw_v7_M_PLA_only.step
v7_PLA_only/USB_gcode/final_v7_XXL_PLA_only_H2DPro_RIGHT.gcode.3mf
3_separate_parts/PRINT_jaw_L_PLA_body_x2.stl
v7_PLA_only/final_v7_S_PLA_only_H2DPro.3mf
v7_PLA_only/stl/trial_v7_L.stl
v7_PLA_only/USB_gcode/final_v7_XXL_PLA_only_H2DPro_LEFT.gcode.3mf
cad/jaw_v6_PLA_body.step
v7_PLA_only/stl/PRINT_jaw_v7_L_PLA_x2.stl
v7_PLA_only/USB_gcode/final_v7_S_PLA_only_H2DPro_RIGHT.gcode.3mf
v7_PLA_only/stl/PRINT_jaw_v7_M_PLA_x2.stl
v7_PLA_only/USB_gcode/final_v7_L_PLA_only_H2DPro_RIGHT.gcode.3mf
v7_PLA_only/stl/trial_v7_S.stl
v7_PLA_only/USB_gcode/final_v7_M_PLA_only_H2DPro_RIGHT.gcode.3mf
v7_PLA_only/stl/PRINT_jaw_v7_S_PLA_x2.stl
v7_PLA_only/USB_gcode/final_v7_M_PLA_only_H2DPro_LEFT.gcode.3mf
v7_PLA_only/USB_gcode/final_v7_L_PLA_only_H2DPro_LEFT.gcode.3mf
v7_PLA_only/USB_gcode/final_v7_S_PLA_only_H2DPro_LEFT.gcode.3mf
v7_PLA_only/USB_gcode/trial_v7_PLA_rings_SML_LEFT.gcode.3mf
v7_PLA_only/USB_gcode/trial_v7_PLA_rings_SML_RIGHT.gcode.3mf
cad/TD005G_model.stl
