fengjh97/robotiq-2f140-td005g-jaw/(commit log)

2026-10-23 Ring jaws for Robotiq 2F-140 x Makita TD005G: trial S/M/L, one-piece PLA+TPU 3MF, CAD, docs, scripts
    Claude-Session: https://claude.ai/code/session_01GS1AM275rFAPtVCH94rw1s
    [PRINT_jaw_v6_PLA_body_x2.stl, PRINT_liner_v6_TPU_fins_x2.stl, TD005G_model.step, TD005G_model.stl, jaw_v6_PLA_body.step, jaw_v6_onepiece_H2DPro.3mf, liner_v6_TPU_fins.step, trial1_PLA_rings_SML.3mf]
2026-10-23 Add final one-piece 3MFs and separate-part STLs in S/M/L sizes matching the trial pieces
    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
    [PRINT_jaw_L_PLA_body_x2.stl, PRINT_jaw_M_PLA_body_x2.stl, PRINT_jaw_S_PLA_body_x2.stl, PRINT_jaw_v6_PLA_body_x2.stl, PRINT_liner_L_TPU_x2.stl, PRINT_liner_M_TPU_x2.stl, PRINT_liner_S_TPU_x2.stl, final_L_onepiece_H2DPro.3mf]
2026-10-26 Add v7 PLA-only ring jaws: tight rigid ring with transverse ridges, S/M/L trial + finals (sliced-verified)
    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
    [PRINT_jaw_v7_L_PLA_x2.stl, PRINT_jaw_v7_M_PLA_x2.stl, PRINT_jaw_v7_S_PLA_x2.stl, final_v7_L_PLA_only_H2DPro.3mf, final_v7_M_PLA_only_H2DPro.3mf, final_v7_S_PLA_only_H2DPro.3mf, jaw_v7_M_PLA_only.step, trial_v7_L.stl]
2026-10-26 v7: set build plate to Textured PEI in 3MF project settings
    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
    [final_v7_L_PLA_only_H2DPro.3mf, final_v7_M_PLA_only_H2DPro.3mf, final_v7_S_PLA_only_H2DPro.3mf, trial_v7_PLA_rings_SML.3mf]
2026-10-26 v7 README: document print settings
    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
2026-10-26 v7: add pre-sliced .gcode.3mf for USB printing (left/right nozzle variants, H2D Pro O1E, thumbnails)
    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
    [final_v7_L_PLA_only_H2DPro_LEFT.gcode.3mf, final_v7_L_PLA_only_H2DPro_RIGHT.gcode.3mf, final_v7_M_PLA_only_H2DPro_LEFT.gcode.3mf, final_v7_M_PLA_only_H2DPro_RIGHT.gcode.3mf, final_v7_S_PLA_only_H2DPro_LEFT.gcode.3mf, final_v7_S_PLA_only_H2DPro_RIGHT.gcode.3mf, trial_v7_PLA_rings_SML_LEFT.gcode.3mf, trial_v7_PLA_rings_SML_RIGHT.gcode.3mf]
2026-10-26 v7: add XXL size (L + 1.2 mm radial), pre-sliced LEFT/RIGHT .gcode.3mf for USB
    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
    [PRINT_jaw_v7_XXL_PLA_x2.stl, final_v7_XXL_PLA_only_H2DPro_LEFT.gcode.3mf, final_v7_XXL_PLA_only_H2DPro_RIGHT.gcode.3mf, jaw_v7_XXL_PLA_only.step]
2026-10-26 v7: add M+5mm size (inner diameter +5 mm vs M, jaw width 68 mm), pre-sliced LEFT/RIGHT gcode
    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
    [PRINT_jaw_v7_Mplus5mm_PLA_x2.stl, final_v7_Mplus5mm_PLA_only_H2DPro_LEFT.gcode.3mf, final_v7_Mplus5mm_PLA_only_H2DPro_RIGHT.gcode.3mf, jaw_v7_Mplus5mm_PLA_only.step]
2026-10-28 docs: add purchase list (H2D Pro filaments, Snapmaker A250T, Robotiq RS485 cabling, ZED cables/USB)
    Claude-Session: https://claude.ai/code/session_01Q9LEqTMu7rK3Ta4xLEDb37
2026-10-28 docs: purchase list — AMS HT for drying, M8 coupling note, ZED 2i + Mini
    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
2026-10-28 docs: purchase list — FANUC CRX wrist (M8 coupling) options
    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
2026-10-28 docs: 5-slot allocation (AMS 2 Pro + AMS HT)
    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
2026-10-28 docs: robot arm is UR5e — gripper on wrist, no external RS485 cabling
    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
2026-10-28 docs: coupling confirmed to fit UR5e wrist
    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
2026-10-28 docs: ZED X Mini 5 m GMSL2 extension, ZED 2i 5 m cable
    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
2026-10-28 docs: ZED 2i original 4 m cable is enough
    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
2026-10-28 docs: backup ZED 2i 10 m cable and USB hub options
    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
